benleamon/sd-macropad/3d-files/Macropad Plate v2-full size test.3mf

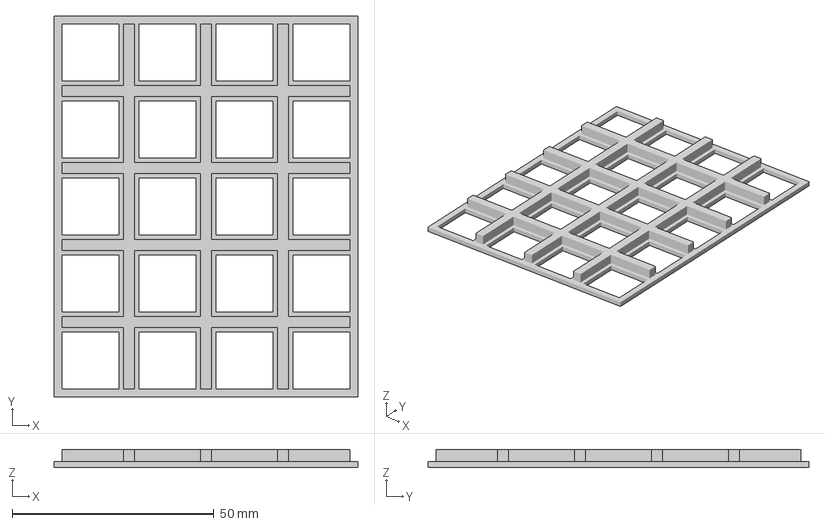
[picture p1: CAD file, 2026-10-06]
3d-files/Macropad Plate v2-full size test.3mf
75.2 x 94.3 x 4.50 mm
