benleamon/sd-macropad/3d-files/Macropad Plate-2.3mf

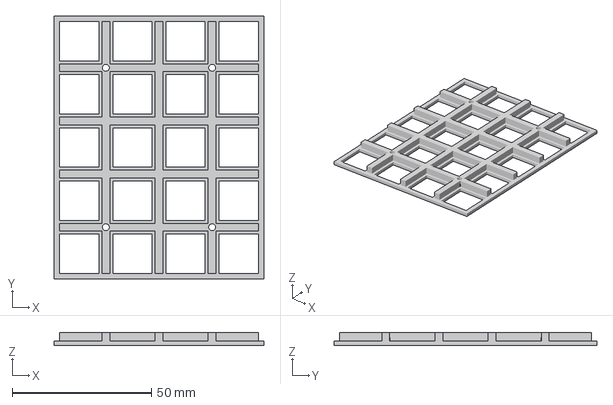
[picture p2: CAD file, 2026-10-06]
3d-files/Macropad Plate-2.3mf
75.2 x 94.3 x 4.50 mm
