benleamon/sd-macropad/3d-files/Macropad calibration-2.3mf

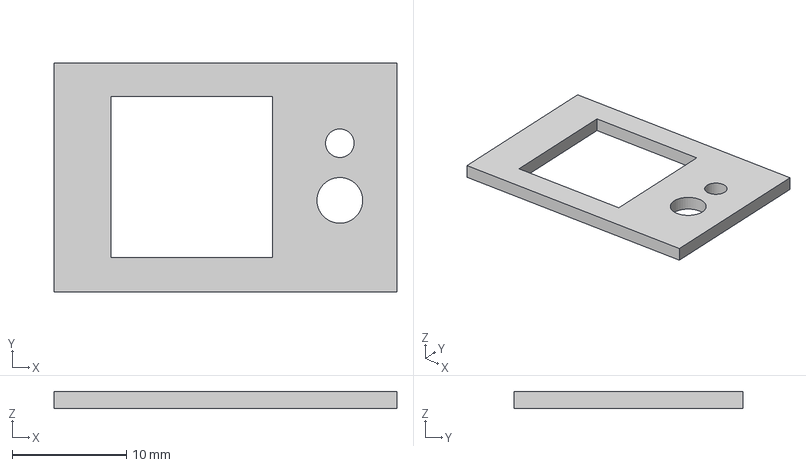
[picture p3: CAD file, 2026-10-06]
3d-files/Macropad calibration-2.3mf
30.0 x 20.0 x 1.50 mm
