benleamon/sd-macropad/3d-files/case.3mf

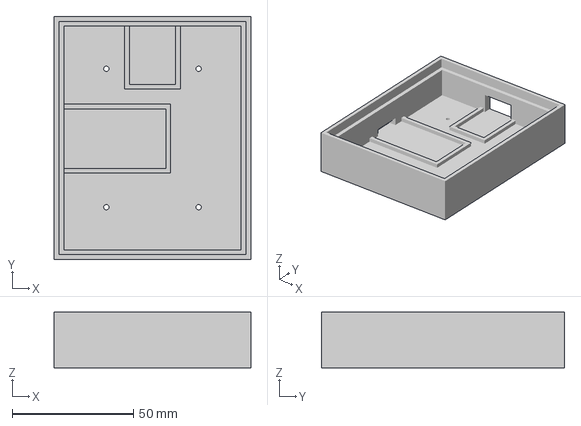
[picture p4: CAD file, 2026-10-06]
3d-files/case.3mf
81.2 x 100.3 x 23.0 mm
