benleamon/sd-macropad/3d-files/Macropad Plate v2.3mf

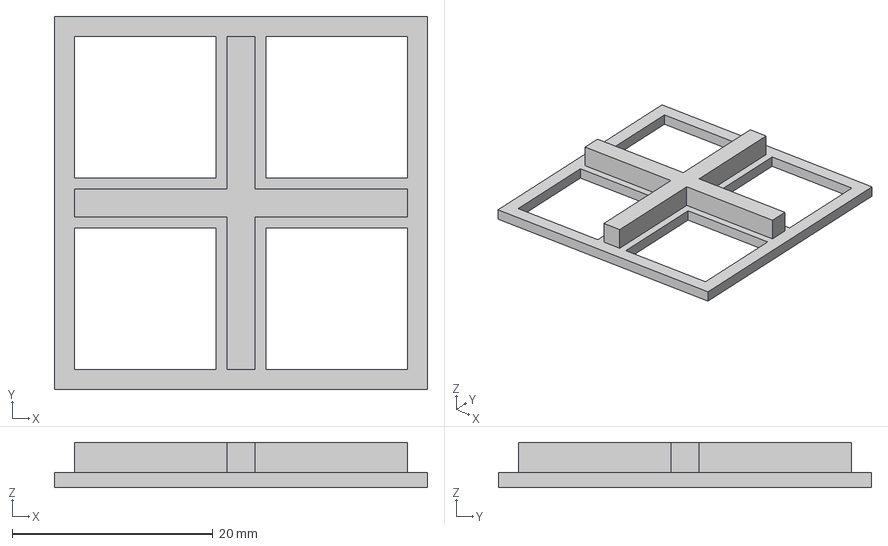
[picture p5: CAD file, 2026-10-06]
3d-files/Macropad Plate v2.3mf
37.1 x 37.1 x 4.50 mm
