benleamon/sd-macropad/3d-files/Macropad Base.3mf

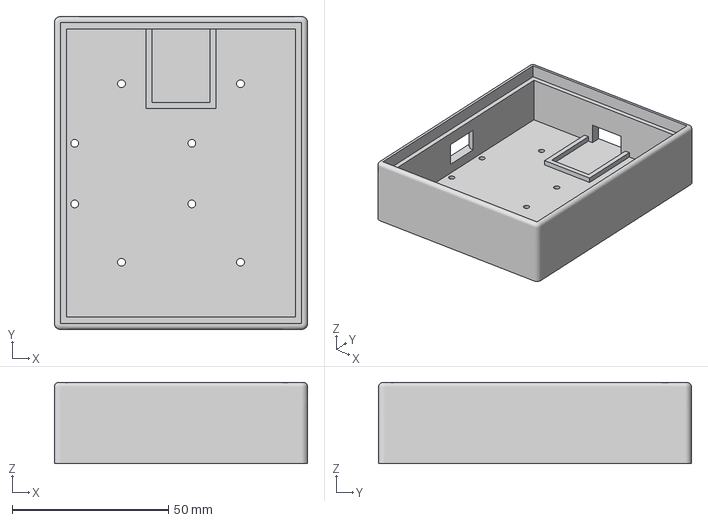
[picture p6: CAD file, 2026-10-06]
3d-files/Macropad Base.3mf
81.2 x 100.2 x 26.0 mm
