benleamon/sd-macropad/3d-files/Macropad Plate v1.3mf

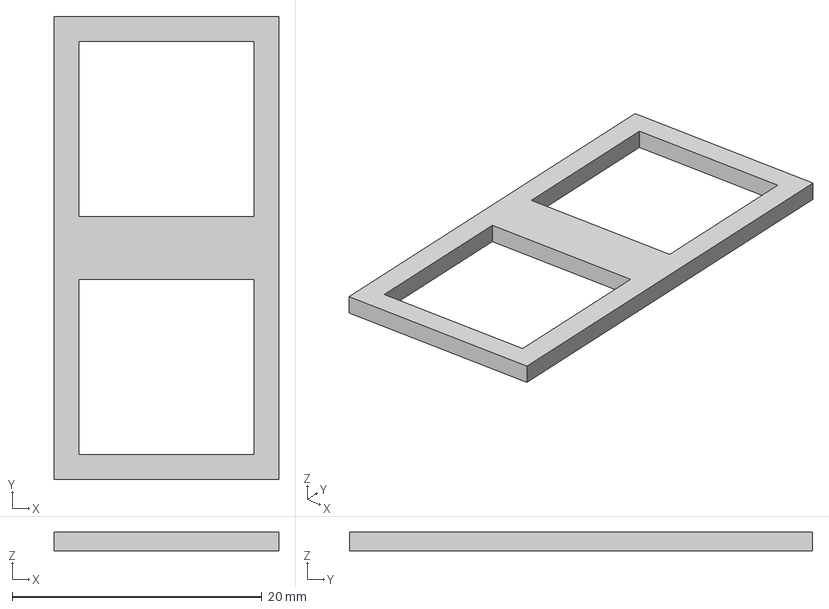
[picture p7: CAD file, 2026-10-06, an earlier design]
3d-files/Macropad Plate v1.3mf
18.0 x 37.0 x 1.50 mm
