benleamon/sd-macropad/(list of files, cad)

Other CAD files:
3d-files/Macropad calibration.3mf
3d-files/plate.3mf
3d-files/Macropad Plate.3mf
