benleamon/sd-macropad/(commit log)

2026-10-06 Add 3d files
    [Macropad Base.3mf, Macropad Plate v1.3mf, Macropad Plate v2-full size test.3mf, Macropad Plate v2.3mf, Macropad Plate-2.3mf, Macropad Plate.3mf, Macropad calibration-2.3mf, Macropad calibration.3mf]
2026-10-06 Add profiles and profile switching
2026-10-07 Add JSON profiles, fn layer, profile switching, usb config editing
